tepaseointenso/infobot/infobotApp/src/main/ic_launcher-playstore.png

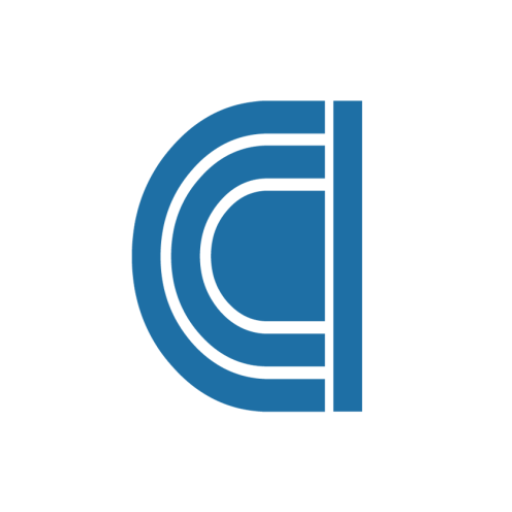
infobotApp/src/main/ic_launcher-playstore.png
