tepaseointenso/infobot/robot-lia/stl/pelvis.stl

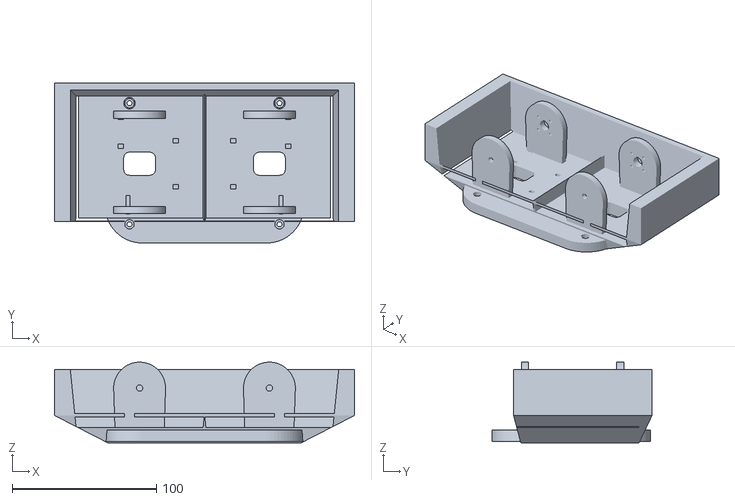
[picture p16: CAD file, 2026-10-30]
robot-lia/stl/pelvis.stl
208.0 x 111.0 x 56.0
