tepaseointenso/infobot/robot-lia/stl/torso_escritorio.stl

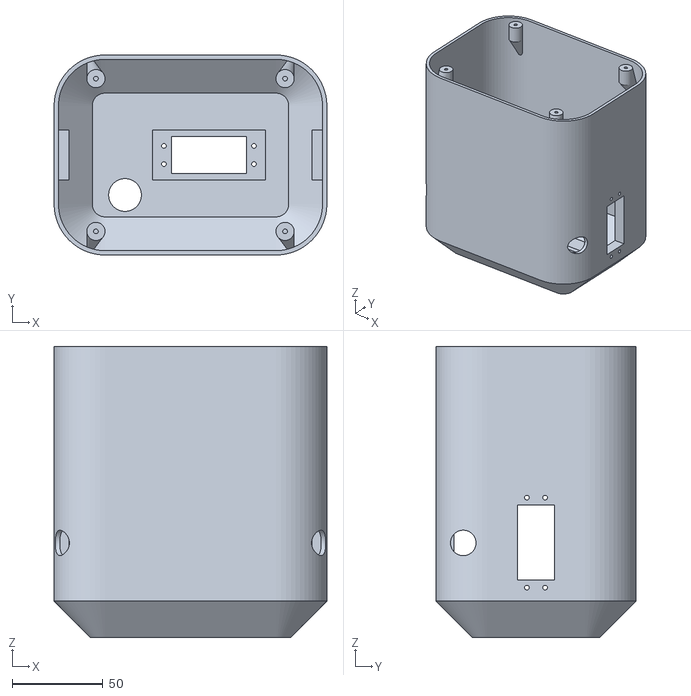
[picture p17: CAD file, 2026-10-30]
robot-lia/stl/torso_escritorio.stl
150.0 x 110.0 x 160.0
