tepaseointenso/infobot/robot-lia/stl/tapa_servo.stl

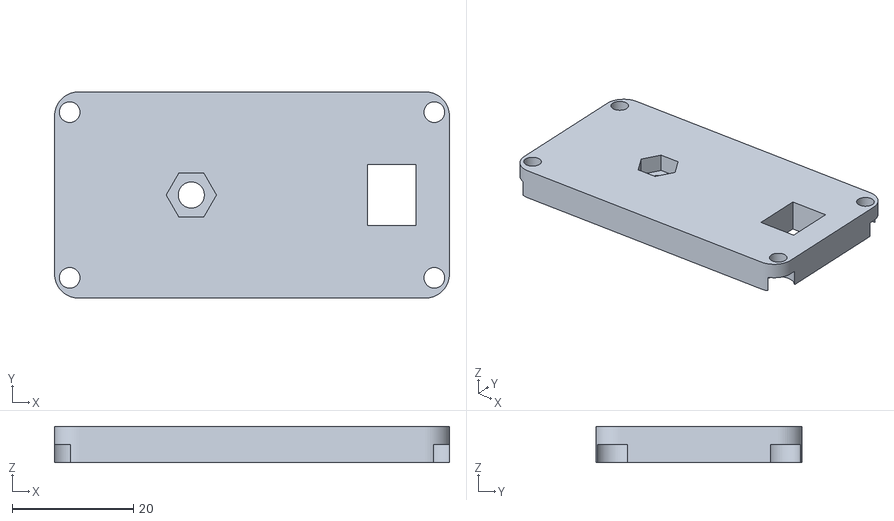
[picture p18: CAD file, 2026-10-30]
robot-lia/stl/tapa_servo.stl
65.1 x 34.0 x 6.00
