tepaseointenso/infobot/robot-lia/stl/pie_izq.stl

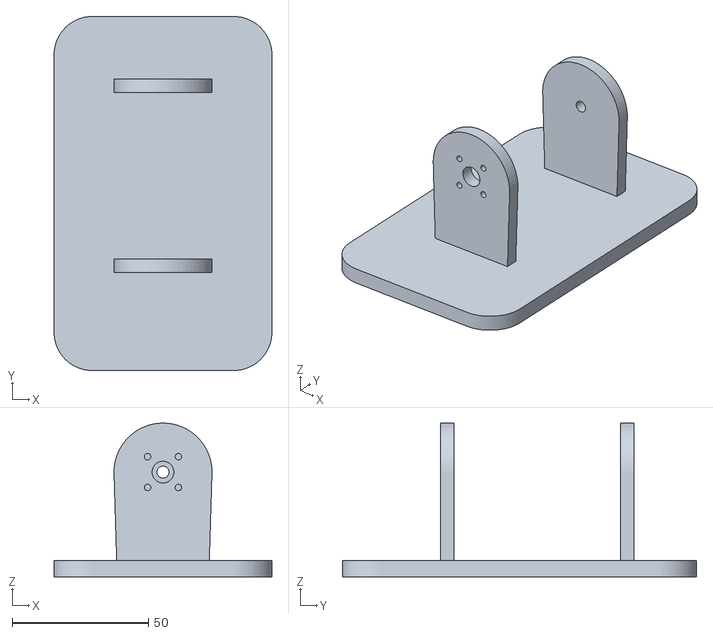
[picture p19: CAD file, 2026-10-30]
robot-lia/stl/pie_izq.stl
80.0 x 130.0 x 56.5
