tepaseointenso/infobot/robot-lia/stl/cuello_tapa.stl

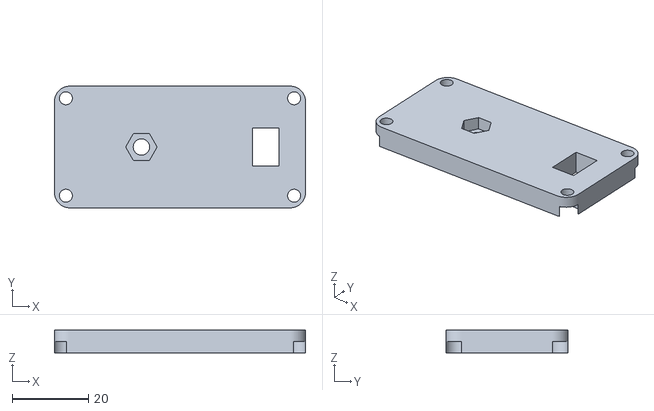
[picture p20: CAD file, 2026-10-30]
robot-lia/stl/cuello_tapa.stl
66.0 x 32.0 x 6.00
