tepaseointenso/infobot/robot-lia/stl/cadera_der.stl

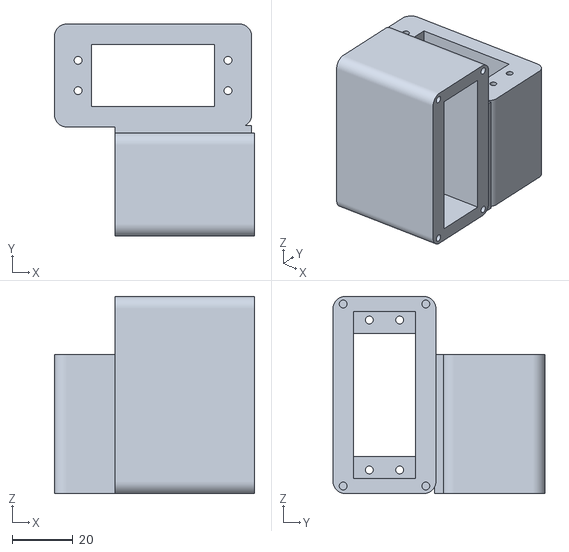
[picture p21: CAD file, 2026-10-30]
robot-lia/stl/cadera_der.stl
66.0 x 70.0 x 65.1
