tepaseointenso/infobot/robot-lia/stl/hombro_der.stl

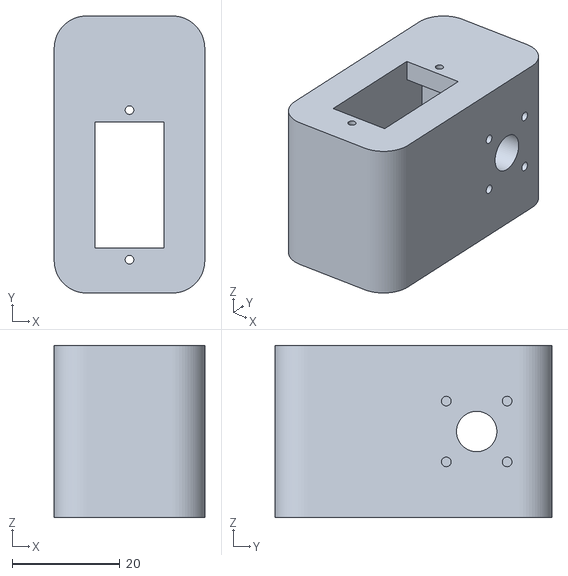
[picture p22: CAD file, 2026-10-30]
robot-lia/stl/hombro_der.stl
28.0 x 51.5 x 32.0
