tepaseointenso/infobot/robot-lia/stl/pierna_izq.stl

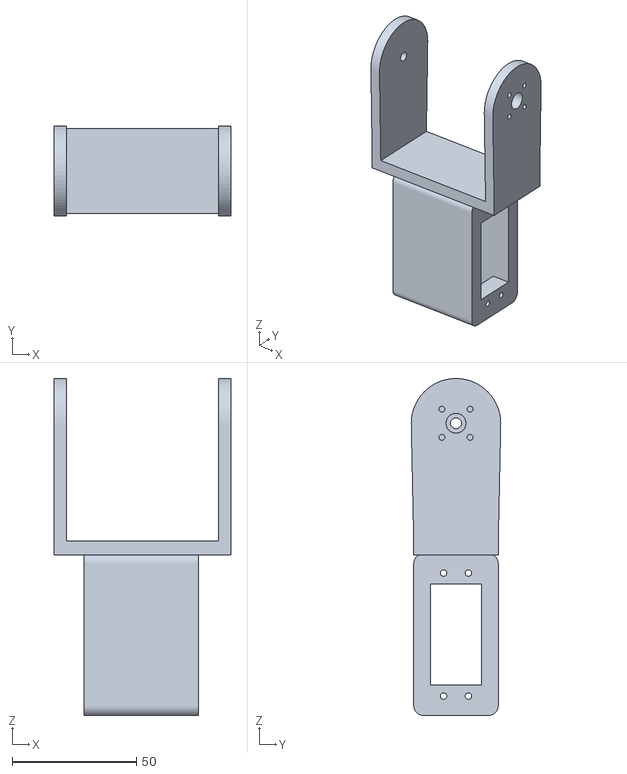
[picture p23: CAD file, 2026-10-30]
robot-lia/stl/pierna_izq.stl
71.0 x 36.0 x 135.5
