tepaseointenso/infobot/robot-lia/stl/tobillo_izq.stl

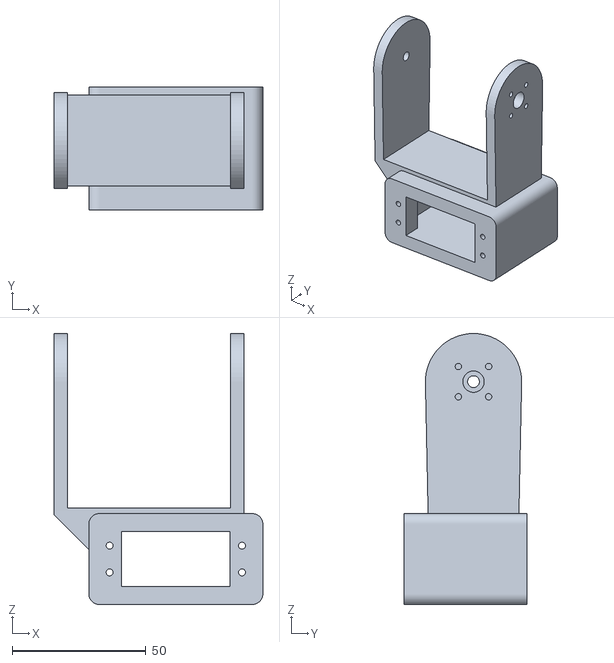
[picture p24: CAD file, 2026-10-30]
robot-lia/stl/tobillo_izq.stl
78.0 x 46.0 x 101.3
