tepaseointenso/infobot/robot-lia/stl/base.stl

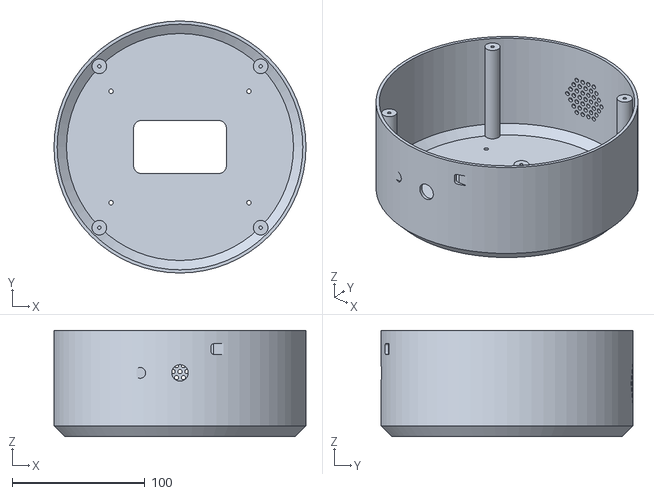
[picture p25: CAD file, 2026-10-30]
robot-lia/stl/base.stl
190.0 x 190.0 x 80.0
