tepaseointenso/infobot/robot-lia/stl/brazo_der.stl

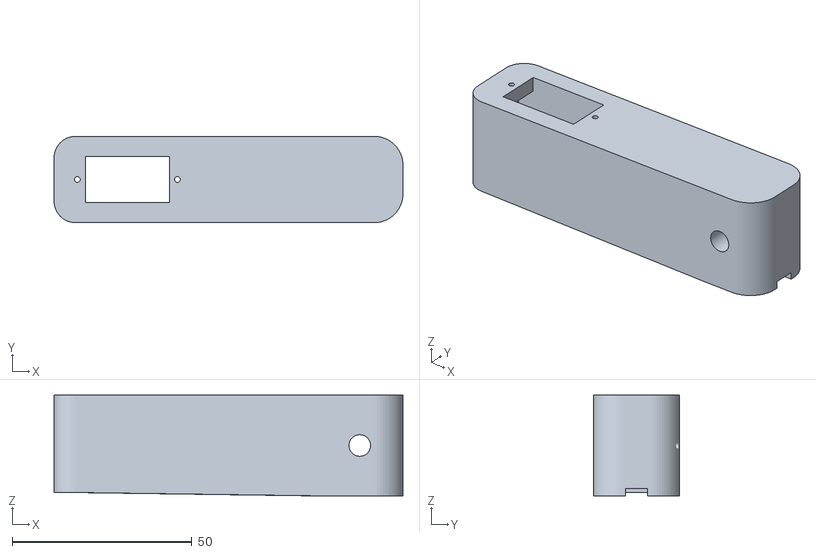
[picture p26: CAD file, 2026-10-30]
robot-lia/stl/brazo_der.stl
97.0 x 24.0 x 28.0
