tepaseointenso/infobot/robot-lia/stl/antebrazo_izq.stl

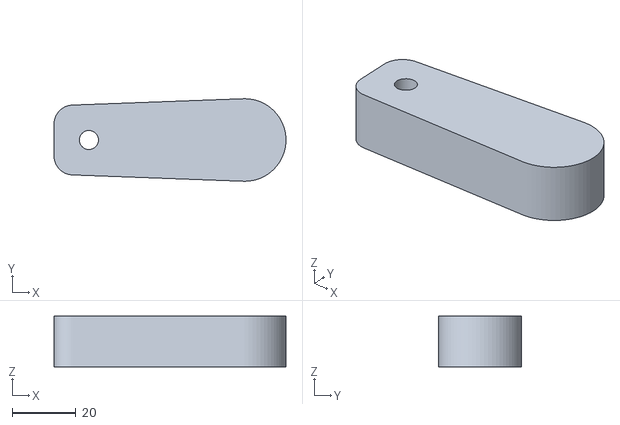
[picture p27: CAD file, 2026-10-30]
robot-lia/stl/antebrazo_izq.stl
73.0 x 26.0 x 16.0
