tepaseointenso/infobot/robot-lia/stl/cuello.stl

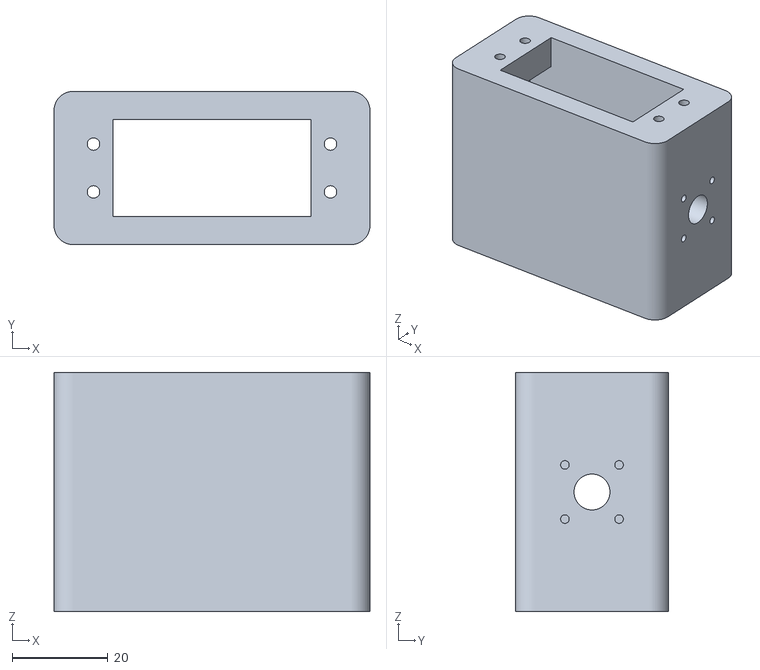
[picture p28: CAD file, 2026-10-30]
robot-lia/stl/cuello.stl
66.0 x 32.0 x 50.0
