tepaseointenso/infobot/robot-lia/stl/cara.stl

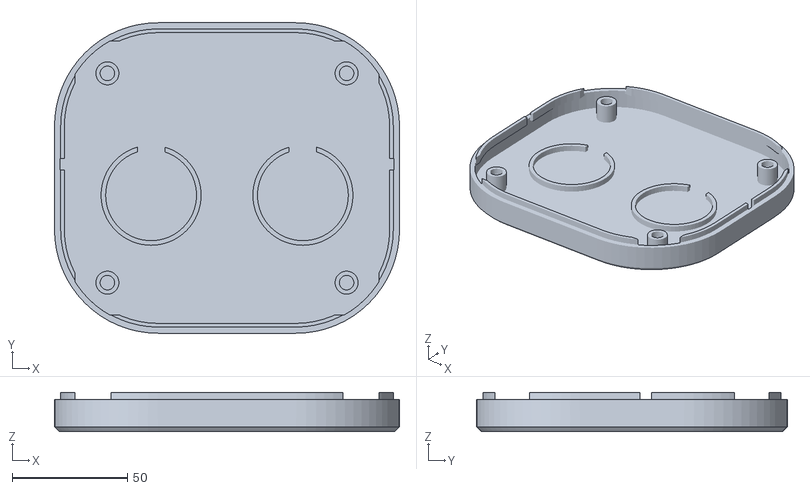
[picture p29: CAD file, 2026-10-30]
robot-lia/stl/cara.stl
150.0 x 135.0 x 17.0
