tepaseointenso/infobot/robot-lia/stl/cabeza.stl

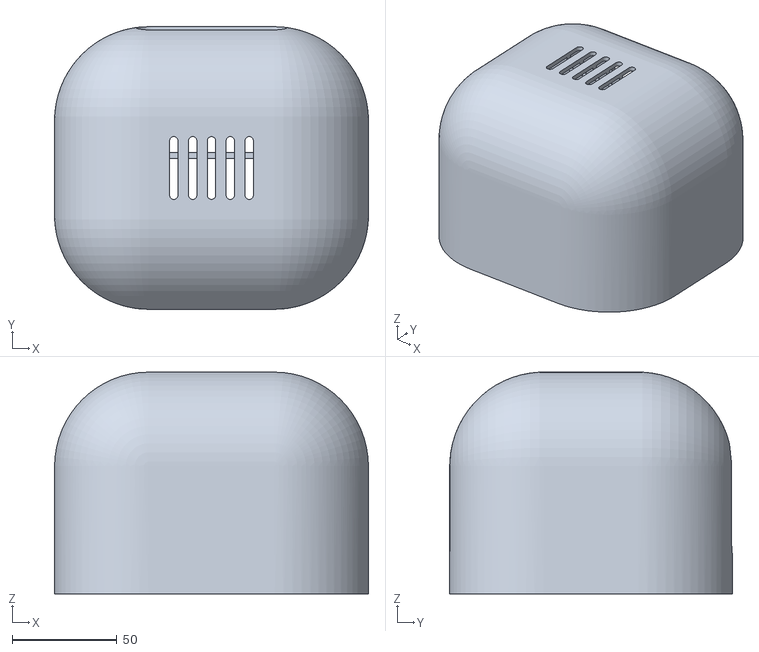
[picture p30: CAD file, 2026-10-30]
robot-lia/stl/cabeza.stl
150.0 x 135.0 x 105.9
