tepaseointenso/infobot/robot-lia/stl/base_tapa.stl

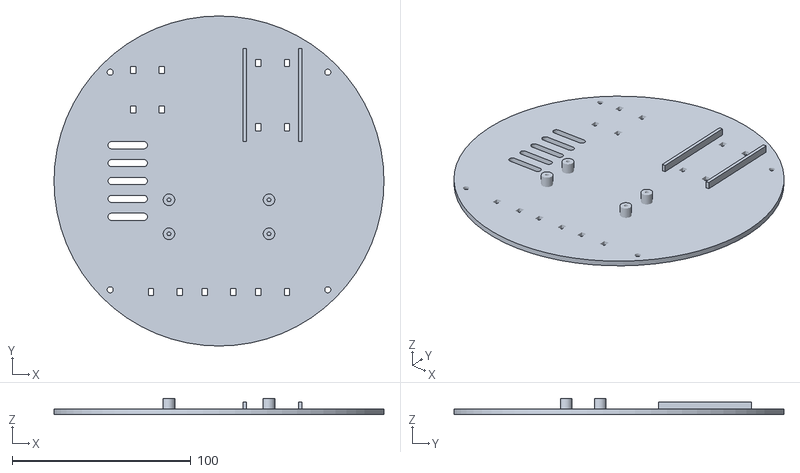
[picture p31: CAD file, 2026-10-30]
robot-lia/stl/base_tapa.stl
184.4 x 184.4 x 9.00
