tepaseointenso/infobot/(list of files, cad)

Other CAD files:
robot-lia/stl/torso.stl
robot-lia/stl/brazo_izq.stl
robot-lia/stl/antebrazo_der.stl
robot-lia/stl/hombro_izq.stl
