tepaseointenso/infobot/(commit log)

2023-09-26 Update funcional de app template y diseno composable
    [group_app_and_permission.xml]
2023-11-21 Funcionamiento general, implementacion de reconocimiento de voz, uso de funciones del robot, navegacion mejorada por voz y mucho mas
2026-10-30 Add Lia: 3D-printable companion robot (OpenSCAD CAD, STLs, ESP32 firmware)
2026-10-30 Lia humanoide: piernas de 5 GDL con DS3218, pelvis, segundo PCA9685 y gestos de pie
2026-10-30 Lia: cadera femenina (cintura 138, cresta 212) y rodilla a 100°
    La pelvis abre la silueta a los costados, por encima de los muslos, sin volverse falda. El hueco de la pierna sube para que el roll a 15° no toque el bulbo. La rodilla queda en 100° porque muslo y tibia se tocan más arriba.
2026-10-30 Lia: galería de vistas con la cadera a la vista
    Renders de frente, tres cuartos, perfil, espalda, saludo, paso, sentadilla y brazos arriba. Con los brazos levantados se lee el ancho de la cadera sobre la cintura.
2026-10-30 Lia: la cadera pasa de bulbo a cresta triangular
    Cada lado termina en una punta a 212 mm, unida a la cintura por encima del hueco de la pierna. El roll a ±15° sigue libre y la pelvis queda en un solo sólido.
2026-10-30 Lia: bloques de color al estilo de Abi
    Cara negra con iris violeta, gorra verde, chaqueta rosa, cadera naranja de 208 mm y piernas en verde y violeta. La gorra es una pieza aparte. El mecanismo de los servos sigue a la vista.
